orsolyasz/CompEnvironments-Summer2022/Code/3-Gyro-Receiver-with-3-MPR121-smooth/3-Gyro-Receiver-with-3-MPR121-smooth.ino

//include libraries for BNO055
#include <Wire.h>
#include <Adafruit_Sensor.h>
#include <Adafruit_BNO055.h>
#include <utility/imumaths.h>

//include libraries for MPR121
#include <Wire.h>
#include "Adafruit_MPR121.h"
#ifndef _BV
#define _BV(bit) (1 << (bit)) 
#endif

//We will have 3 MPR121 capacitive sensors attached, on
//different addresses, as explained in their initializer function
Adafruit_MPR121 cap1 = Adafruit_MPR121();
Adafruit_MPR121 cap2 = Adafruit_MPR121();
Adafruit_MPR121 cap3 = Adafruit_MPR121();


//Two BNO gyroscopes communicating through I2C
//one sensor of them has ADR connected to 3 volts to change the default address
Adafruit_BNO055 bno = Adafruit_BNO055(55, 0x28);
Adafruit_BNO055 bno2 = Adafruit_BNO055(55, 0x29);


//for Hardware Serial Communication:
//Leonardo Board One Pin0 is connected to Leonardo Board Two Pin 1
//Board One Pin1 is connected to Board Two Pin0
char inChar;
char inData[10];
int dataLength = 0;
String gyro3Readings = "0000,0000,";


//for gyroscope info
float gy1y=0;
float gy1z=0;
float gy1yTarget=0;
float gy1zTarget=0;
float gy2y=0;
float gy2z=0;
float gy3y=0;
float gy3z=0;

//for capacitive sensors
uint16_t currtouched1 = 0;
uint16_t currtouched2 = 0;
uint16_t currtouched3 = 0;
byte cap1values[12]= {0};
byte cap2values[12]= {0};
byte cap3values[12]= {0};
uint8_t cap1count = 0;
uint8_t cap2count = 0;
uint8_t cap3count = 0;
float cap1active = 0;
float cap2active = 0;
float cap3active = 0;
byte cap1target = 0;
byte cap2target = 0;
byte cap3target = 0;
byte checkpoint1 = 0;
byte checkpoint2 = 0;
byte checkpoint3 = 0;
const uint8_t threshold=2;

void setup() {
  // start Serial to write to computer, Serial1 to listen to the sender board
  Serial.begin(9600);
  while (!Serial) { // needed to keep leonardo/micro from starting too fast!
    delay(10);
  }
  Serial1.begin(9600);
  while (!Serial1) { // needed to keep leonardo/micro from starting too fast!
    delay(10);
  }
  Serial.println("starting up");

  //Initialize the gyroscopes
  initializeGyros();

  // initializing MPR121 capacitive sensors
  initializeMPRs();

}

void loop() {
  //Serial.println("looping");

  //get all three gyro data
  readGyro3Data();
  readGyro1Data();
  readGyro2Data();

  //reset our cap sensor values
  resetArray(cap1values);
  resetArray(cap2values);
  resetArray(cap3values);
  cap1count = 0;
  cap2count = 0;
  cap3count = 0;

  //get all three MPR121 readings
  readMPRs();
  cap1active=checkActivation(cap1count, cap1target, cap1active, threshold);
  cap2active=checkActivation(cap2count, cap2target, cap2active, threshold);
  cap3active=checkActivation(cap3count, cap3target, cap3active, threshold);

  //check if stations are "activated" as defined by our threshold
  if(cap1active<0.2){
    checkpoint1=0;
    } else {checkpoint1=1;}
  if(cap2active<0.2){
    checkpoint2=0;
    } else {checkpoint2=1;}
  if(cap3active<0.2){
    checkpoint3=0;
    } else {checkpoint3=1;}

  Serial.print("GYRO1: ");
  Serial.print(gy1y);
  Serial.print(",");
  Serial.print(gy1z);
  Serial.print("   GYRO2: ");
  Serial.print(gy2y);
  Serial.print(",");
  Serial.print(gy2z);
  Serial.print("   GYRO3: ");
  Serial.print(gy3y);
  Serial.print(",");
  Serial.print(gy3z);
  Serial.println("");
  
  Serial.print("is cap1 activated?");
  Serial.println(checkpoint1);
  Serial.print("is cap2 activated?");
  Serial.println(checkpoint2);
  Serial.print("is cap3 activated?");
  Serial.println(checkpoint3);

  delay(2);


}
